SR211007/MONGO_GARDEN/site/image-3.jpeg

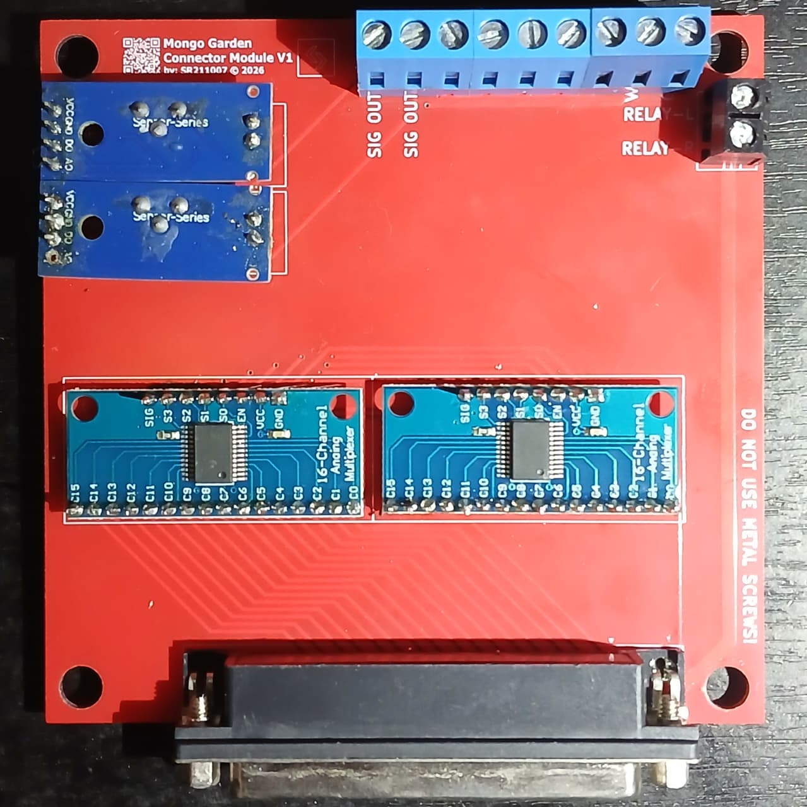
site/image-3.jpeg
