SR211007/MONGO_GARDEN/site/image-5.jpeg

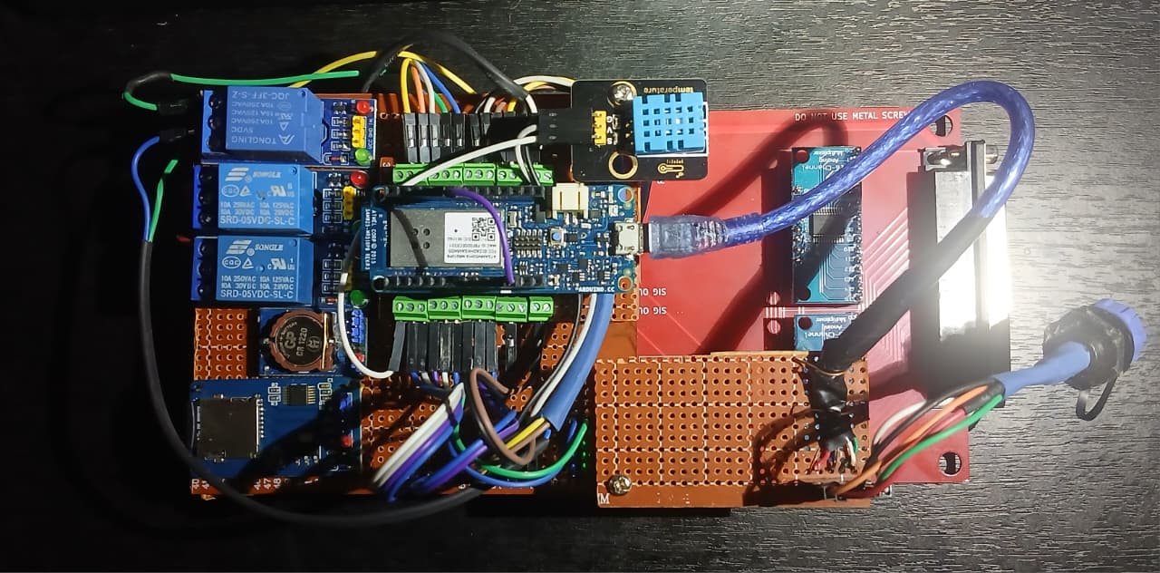
site/image-5.jpeg
