SR211007/MONGO_GARDEN/site/image-2.png

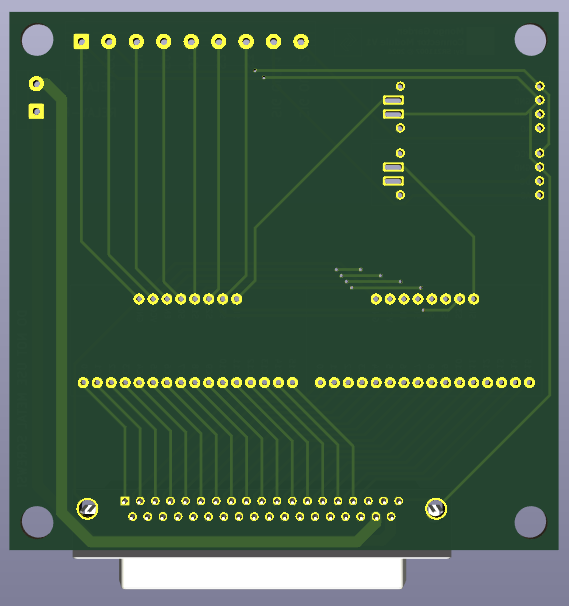
site/image-2.png
