SR211007/MONGO_GARDEN/site/image-4.jpeg

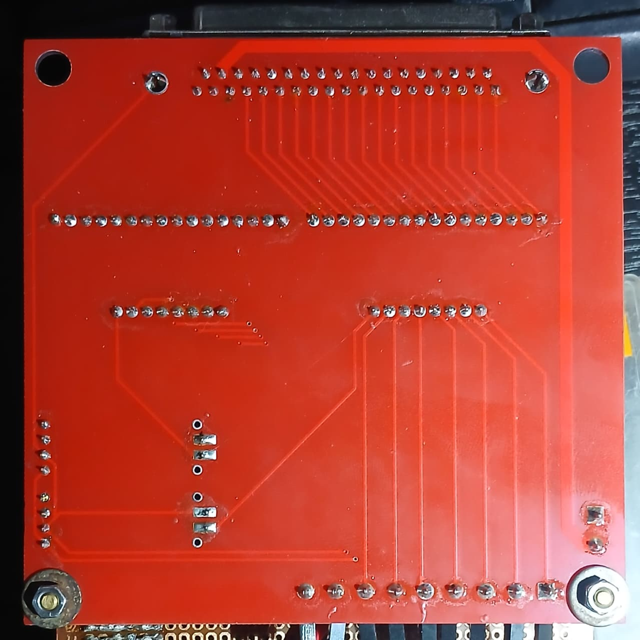
site/image-4.jpeg
