SR211007/MONGO_GARDEN/site/image-6.jpeg

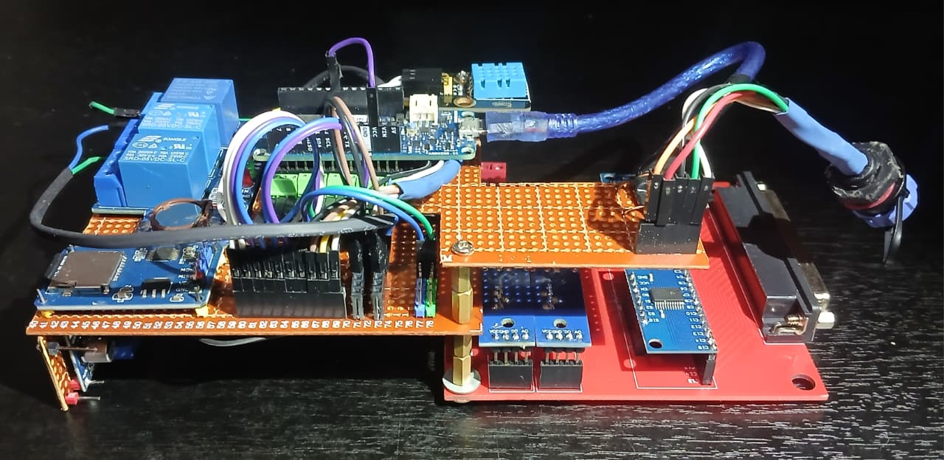
site/image-6.jpeg
