SR211007/MONGO_GARDEN/site/image.png

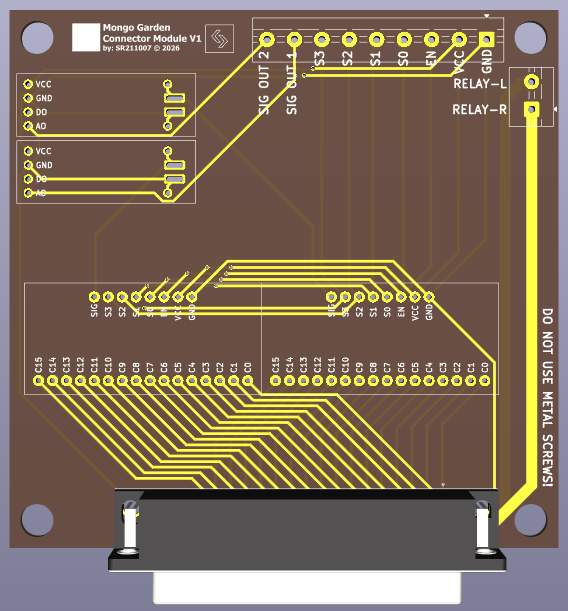
site/image.png
