SR211007/MONGO_GARDEN/Stuff/Schematics/Soil-Moisture-Sensor-Module-Schematic.png

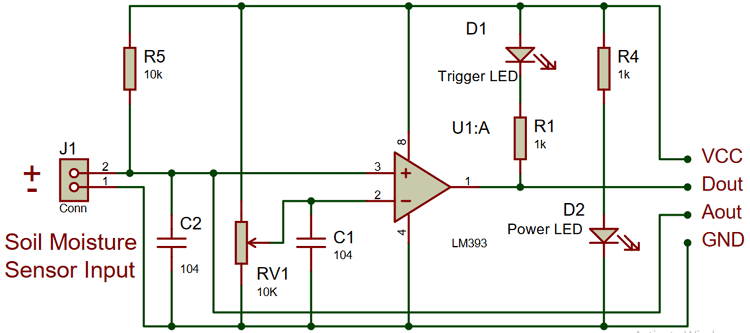
Stuff/Schematics/Soil-Moisture-Sensor-Module-Schematic.png
