SR211007/MONGO_GARDEN/MONGO_PCB_DESIGN_V3/PCB_V3/PCB_V3.kicad_pcb

## KiCad design MONGO_PCB_DESIGN_V3/PCB_V3/PCB_V3.kicad_pcb (2026-09-19)

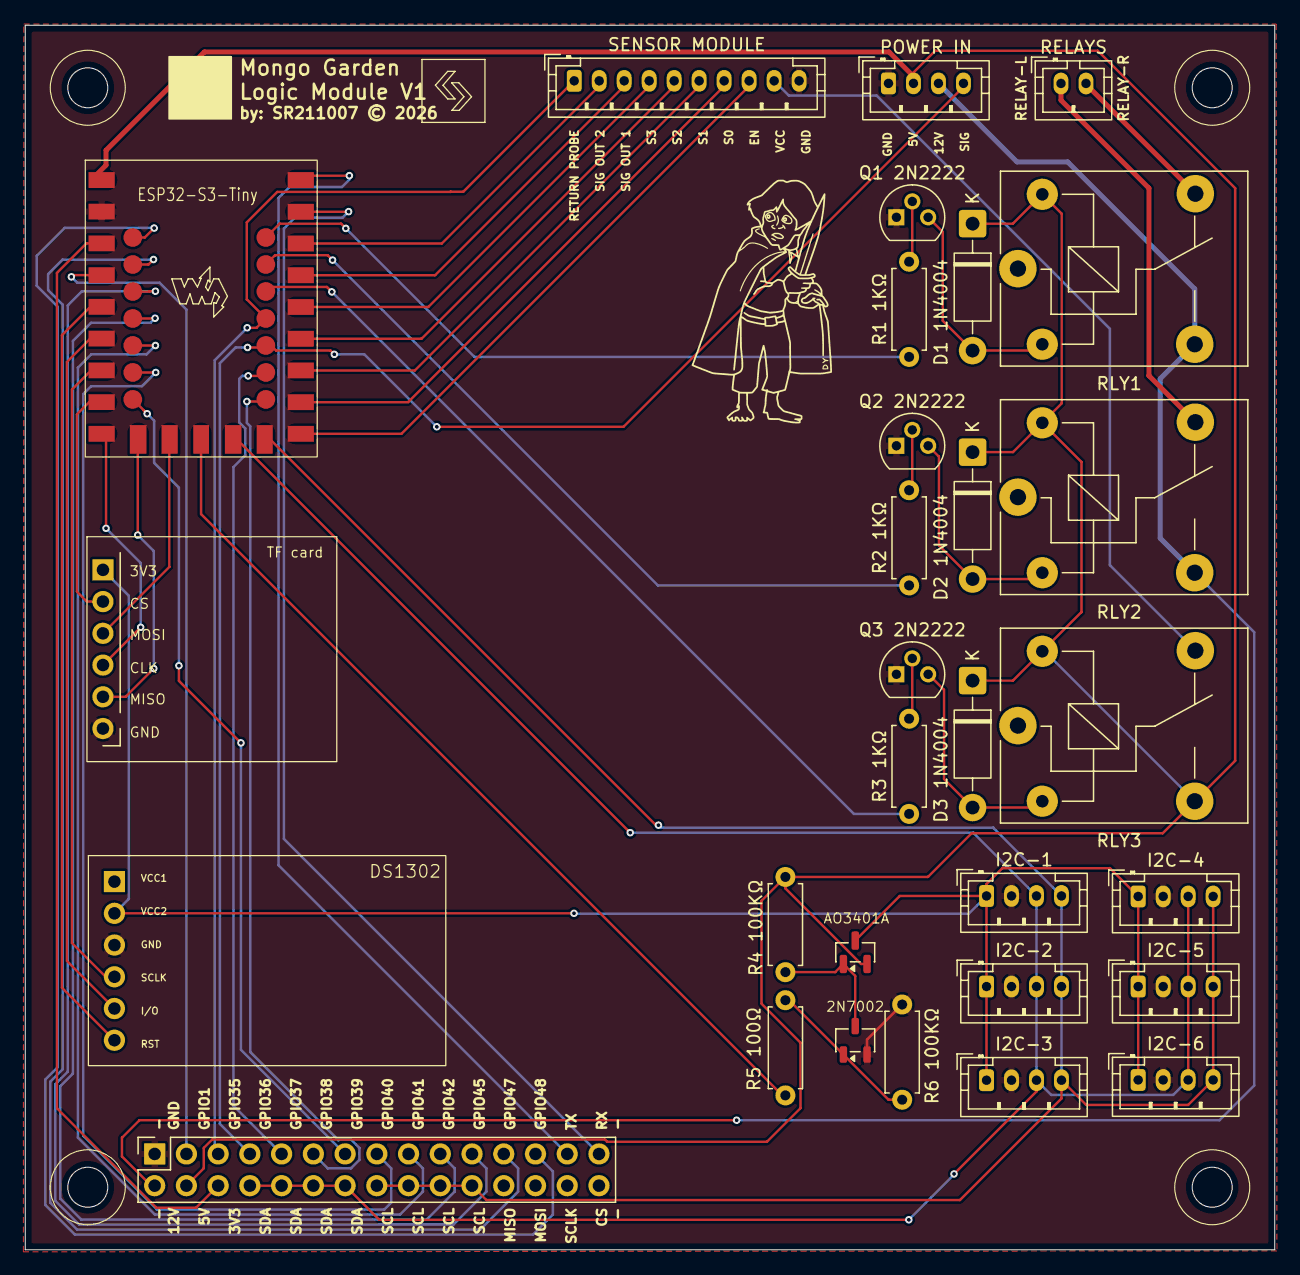
[picture p8: board PCB_V3.kicad_pcb from above]

Board: 2 copper layers, 100.0 x 98.0 mm, 28 parts (0 on the bottom side), 17 nets.

Parts:
2N7002: SOT-23-3
AO3401A: SOT-23
D1 1N4004, D2 1N4004, D3 1N4004: D_DO-41_SOD81_P10.16mm_Horizontal
DS1302: DS1302
I2C-1, I2C-2, I2C-3, I2C-4, I2C-5, I2C-6: JST_PH_B4B-PH-K_1x04_P2.00mm_Vertical
POWER IN: JST_PH_B4B-PH-K_1x04_P2.00mm_Vertical
Q1 2N2222, Q2 2N2222, Q3 2N2222: TO-92
R1 1KΩ, R2 1KΩ, R3 1KΩ, R4 100KΩ, R5 100Ω, R6 100KΩ: R_Axial_DIN0207_L6.3mm_D2.5mm_P7.62mm_Horizontal
RELAYS: JST_PH_B2B-PH-K_1x02_P2.00mm_Vertical
RLY1, RLY2, RLY3: Relay_SPDT_SANYOU_SRD_Series_Form_C
SENSOR MODULE: JST_PH_B10B-PH-K_1x10_P2.00mm_Vertical
TF card: MICROSD

Connections:
5V: AO3401A.2, D1 1N4004.1, D2 1N4004.1, D3 1N4004.1, POWER IN.2, R4 100KΩ.2, RLY1.5, RLY2.5, RLY3.3, RLY3.5
5V_RAIL: AO3401A.3, DS1302.2, I2C-1.1, I2C-2.1, I2C-3.1, I2C-4.1, I2C-5.1, I2C-6.1, TF card.6
12V: POWER IN.3, RLY1.3, RLY2.3
GATE_2N7002_PULLDOWN: 2N7002.1, R5 100Ω.1, R6 100KΩ.1
GATE_AO3401A_PULLUP: 2N7002.3, AO3401A.1, R4 100KΩ.1
GND: 2N7002.2, DS1302.3, I2C-1.2, I2C-2.2, I2C-3.2, I2C-4.2, I2C-5.2, I2C-6.2, POWER IN.1, Q1 2N2222.1, Q2 2N2222.1, Q3 2N2222.1, R6 100KΩ.2, SENSOR MODULE.10, TF card.1
Q1-D1: D1 1N4004.2, Q1 2N2222.3, RLY1.2
Q2-D2: D2 1N4004.2, Q2 2N2222.3, RLY2.2
Q3-D3: D3 1N4004.2, Q3 2N2222.3, RLY3.2
R1-Q1: Q1 2N2222.2, R1 1KΩ.2
R2-Q2: Q2 2N2222.2, R2 1KΩ.2
R3-Q3: Q3 2N2222.2, R3 1KΩ.2
RELAY-L: RELAYS.1, RLY2.4
RELAY-R: RELAYS.2, RLY1.4
SCL: I2C-1.4, I2C-2.4, I2C-3.4, I2C-4.4, I2C-5.4, I2C-6.4
SDA: I2C-1.3, I2C-2.3, I2C-3.3, I2C-4.3, I2C-5.3, I2C-6.3
VCC_CONECTOR_MODULE: RLY3.4, SENSOR MODULE.9
