SR211007/MONGO_GARDEN/(commit log)

2026-02-19 cambios estéticos y de comentarios
2026-02-24 PCB FORLDER CREATED
    [MONGO_PCB.kicad_pcb, MONGO_PCB.kicad_sch]
2026-02-24 some changes
    [MONGO_PCB-B_Cu.gbr, MONGO_PCB-B_Mask.gbr, MONGO_PCB-B_Paste.gbr, MONGO_PCB-B_Silkscreen.gbr, MONGO_PCB-Edge_Cuts.gbr, MONGO_PCB-F_Cu.gbr, MONGO_PCB-F_Mask.gbr, MONGO_PCB-F_Paste.gbr]
2026-05-14 PCB work
    [MONGO_PCB.kicad_pcb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]
2026-05-14 PCB modif
    [MONGO_PCB_DESIGN_V2.kicad_pcb]
2026-05-18 some work on pcb
    [MONGO_PCB_DESIGN_V2.kicad_pcb]
2026-05-18 pcb modfng
    [MONGO_PCB_DESIGN_V2.kicad_pcb, TESTMONGOONE_bom.csv, TESTMONGOONE_designators.csv, TESTMONGOONE_positions.csv]
2026-07-04 Fix folders duplic.
    [MONGO_PCB_DESIGN_V2.kicad_pcb, MONGO_PCB_DESIGN_V2.kicad_sch, TESTMONGOONE_bom.csv, TESTMONGOONE_designators.csv, TESTMONGOONE_positions.csv]
