SR211007/MONGO_GARDEN/(notices)

Notices in the files:
MONGO_PCB_DESIGN_V2/MONGO_PCB_DESIGN_V2.kicad_pcb:
by: SR211007 © 2026
